MajoGuirola/Eje-404/Carro/Frente.jpeg

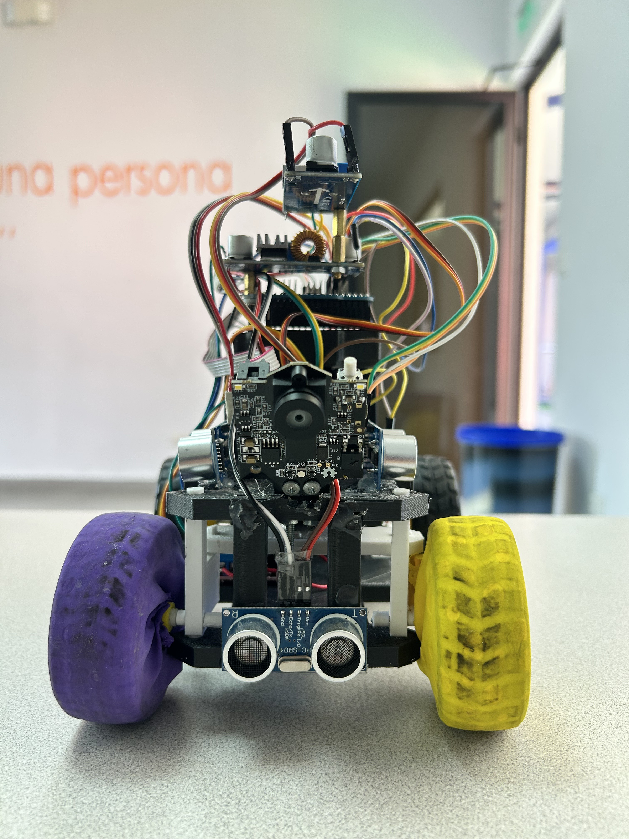
Carro/Frente.jpeg
