MajoGuirola/Eje-404/Fotos/IMG_0653.jpg

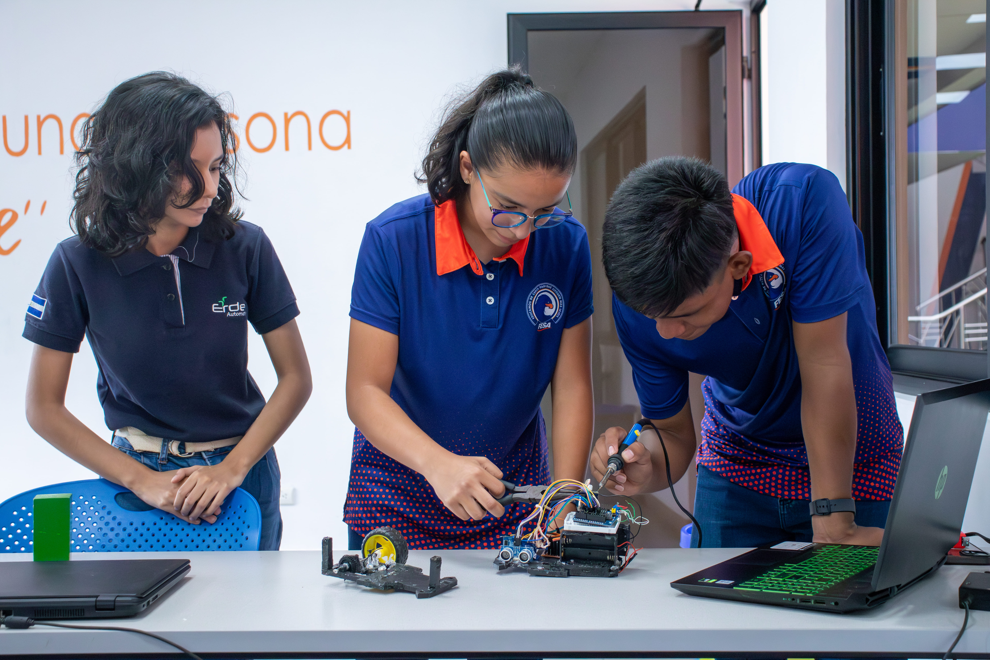
Fotos/IMG_0653.jpg
