MajoGuirola/Eje-404/Carro/Atras.jpeg

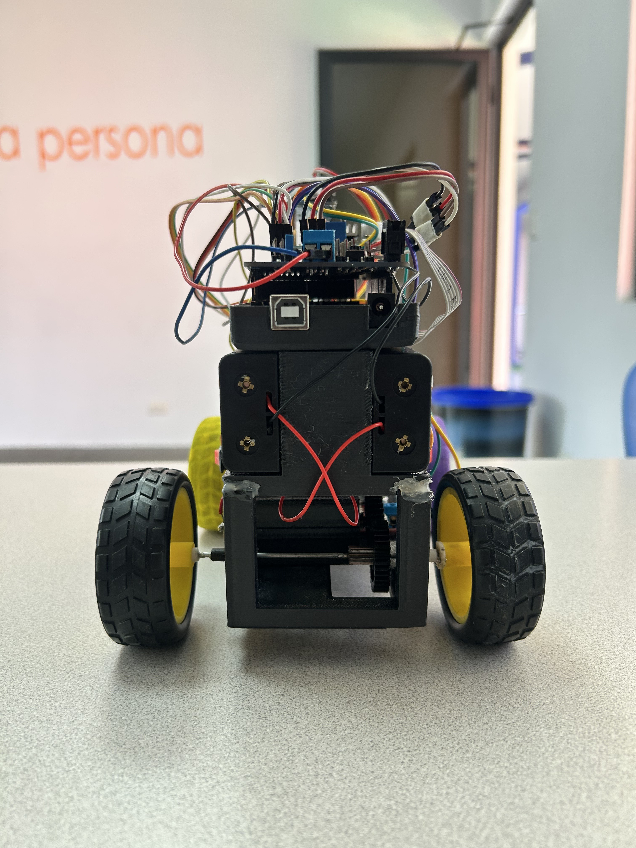
Carro/Atras.jpeg
