MajoGuirola/Eje-404/Carro/Derecha.jpeg

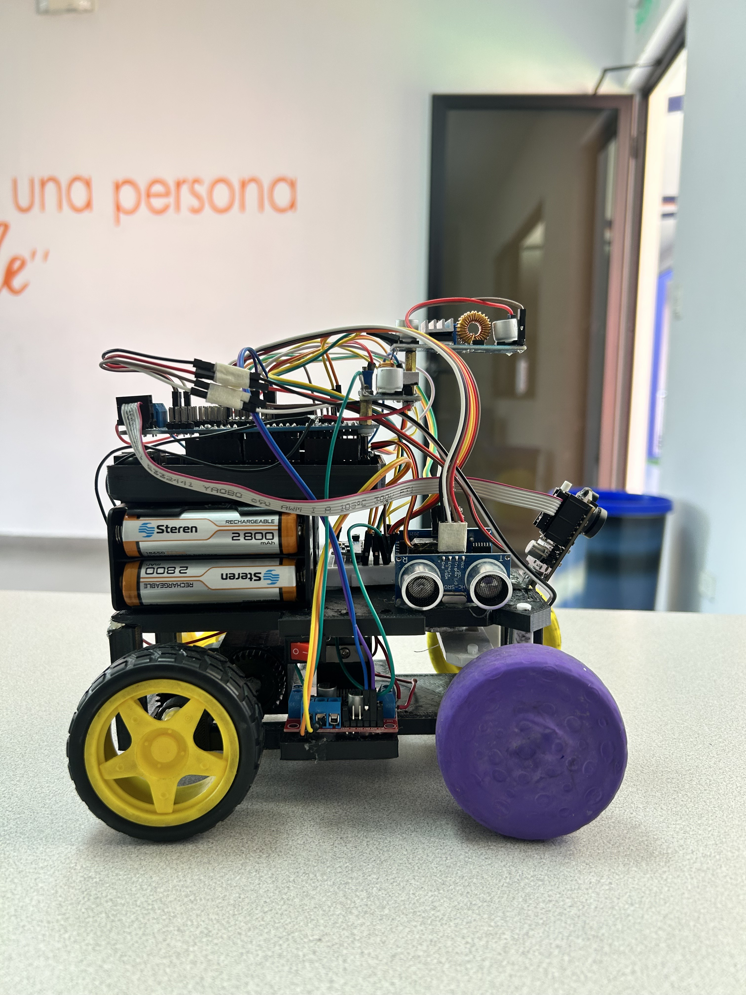
Carro/Derecha.jpeg
