MajoGuirola/Eje-404/Carro/Izquierda.jpeg

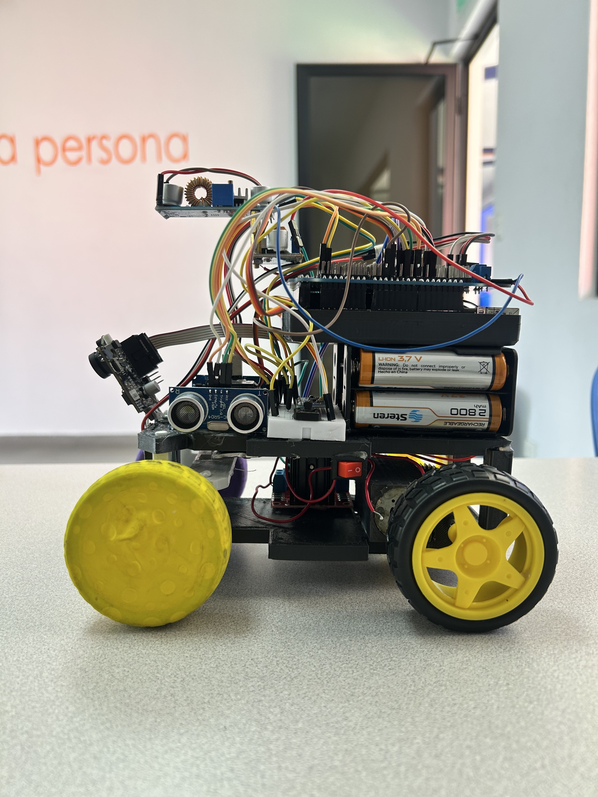
Carro/Izquierda.jpeg
