MajoGuirola/Eje-404/Diagramas y circuito/Diagrama de conexiones.png

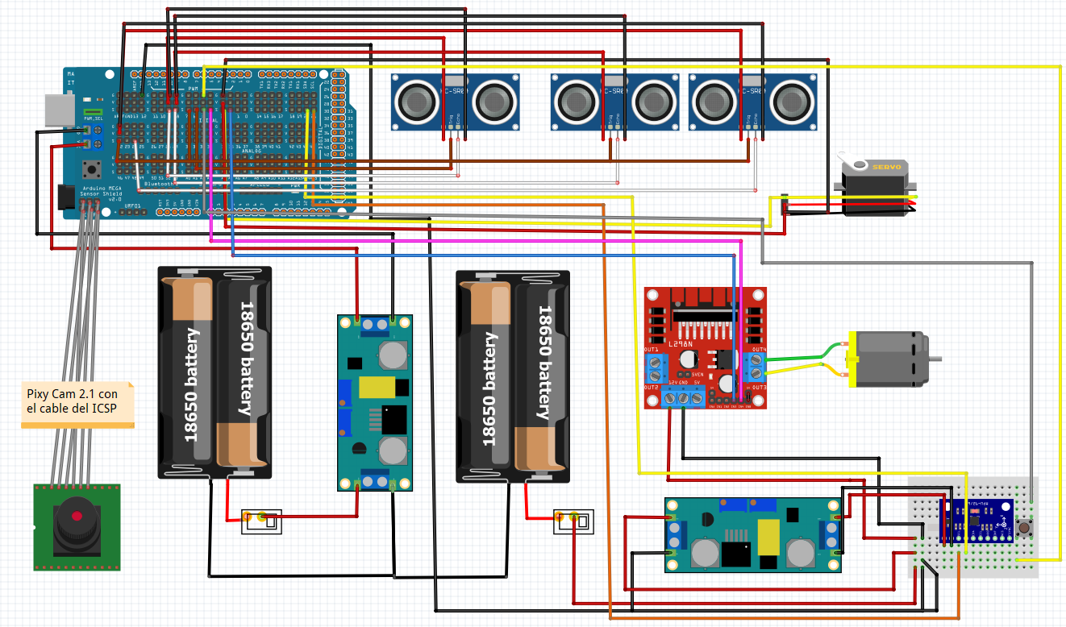
Diagramas y circuito/Diagrama de conexiones.png
