MajoGuirola/Eje-404/Diagramas y circuito/Diagrama de Flujo Desafío Abierto (2).png

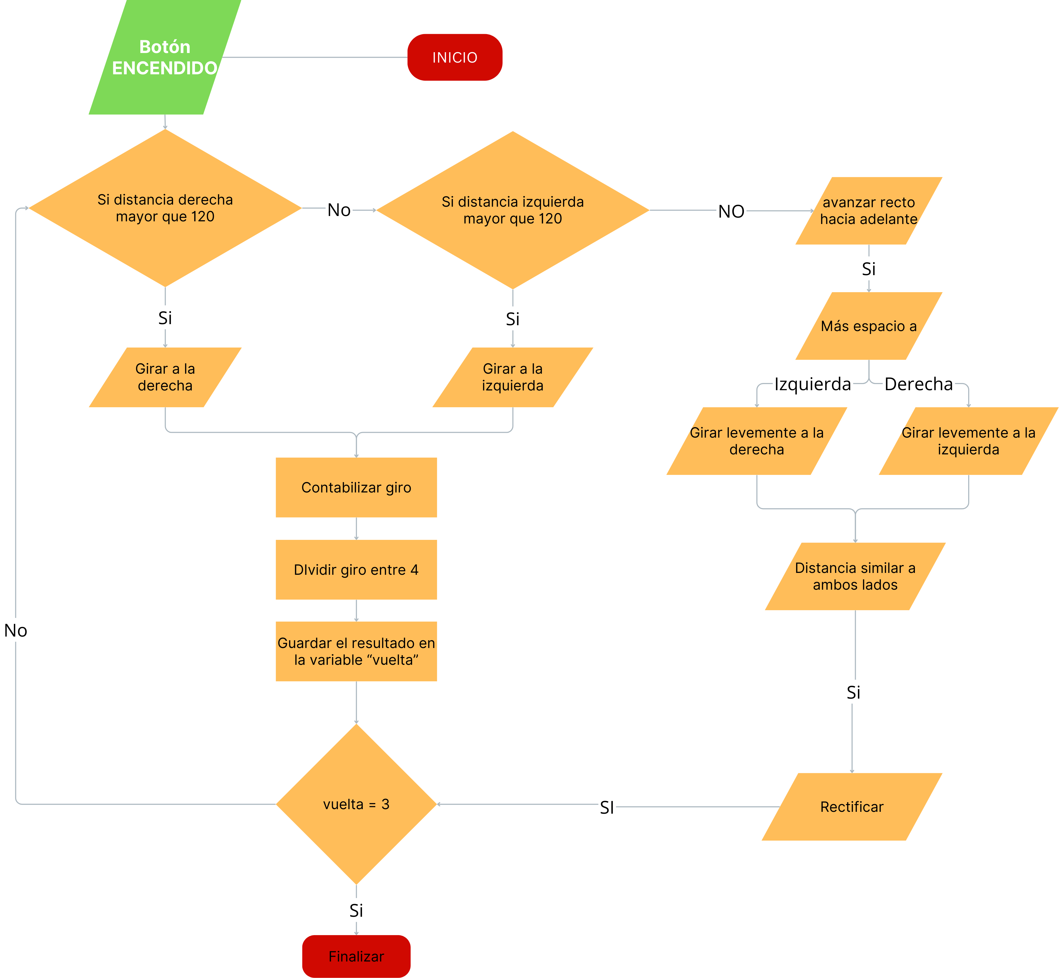
Diagramas y circuito/Diagrama de Flujo Desafío Abierto (2).png
