MajoGuirola/Eje-404/Diagramas y circuito/WhatsApp Image 2025-08-29 at 9.57.32 PM.jpeg

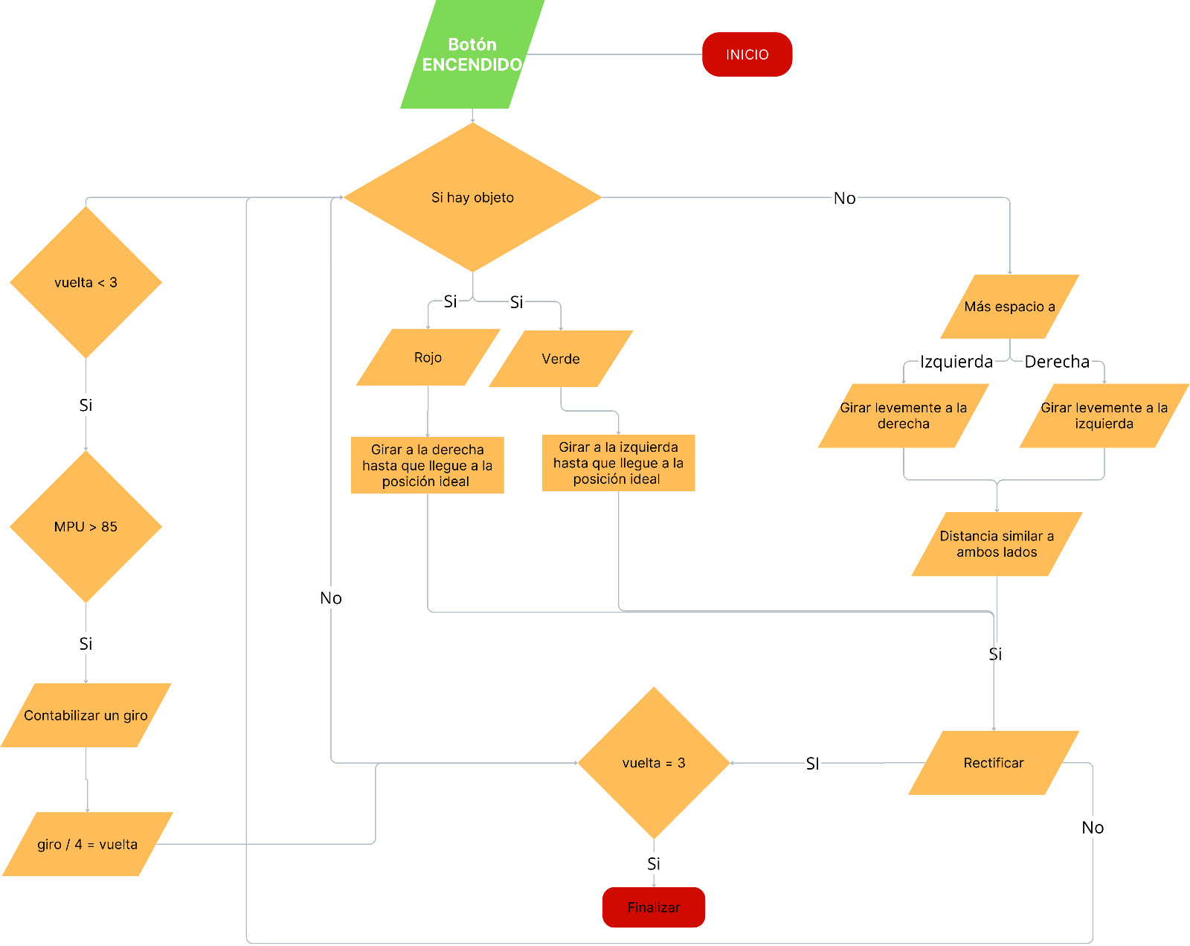
Diagramas y circuito/WhatsApp Image 2025-08-29 at 9.57.32 PM.jpeg
