MajoGuirola/Eje-404/Fotos/IMG_0657.jpg

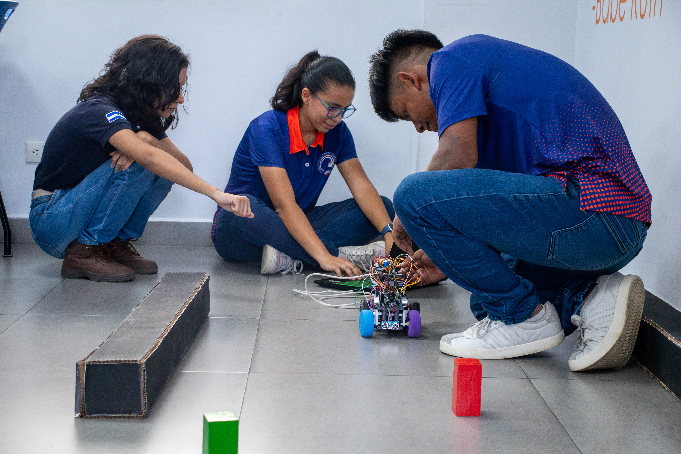
Fotos/IMG_0657.jpg
