MajoGuirola/Eje-404/Carro/Abajo.jpeg

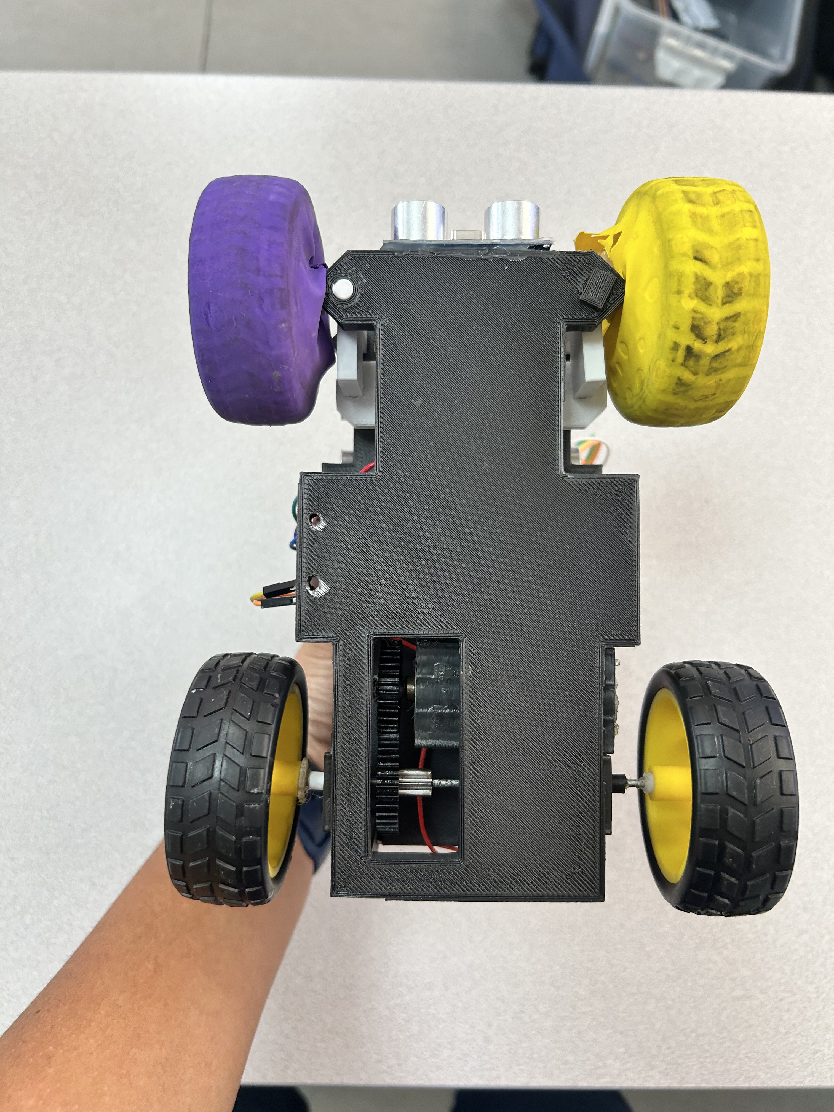
Carro/Abajo.jpeg
