MajoGuirola/Eje-404/Carro/Arriba.jpeg

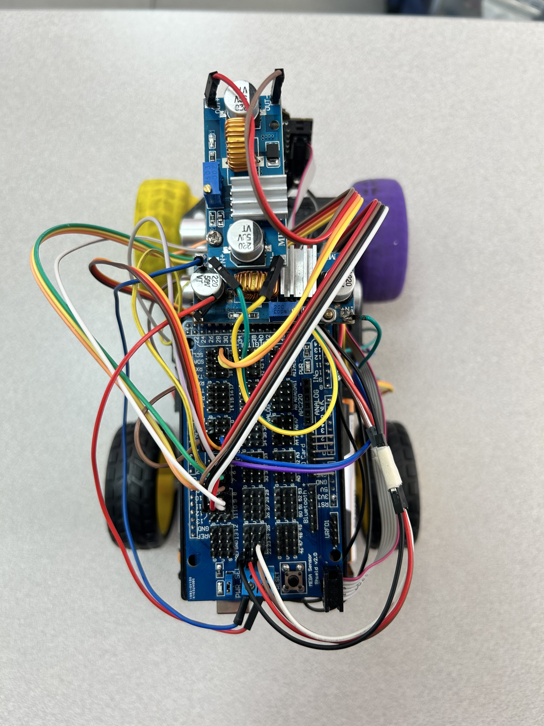
Carro/Arriba.jpeg
